JayceWork/Hardware_file/3D_step/ANT/ANT_5p5mmx2mm.step

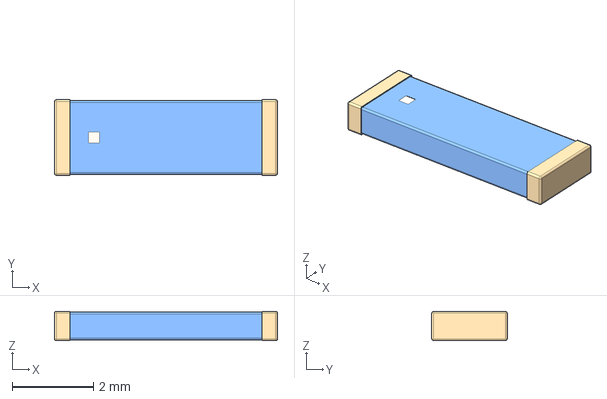
[picture p1: CAD file, 2022-02-21]
3D_step/ANT/ANT_5p5mmx2mm.step
5.50 x 1.86 x 0.727 mm
