JayceWork/Hardware_file/3D_step/Connector/1P25mm/1P25mm-2P-Horizontal.stp

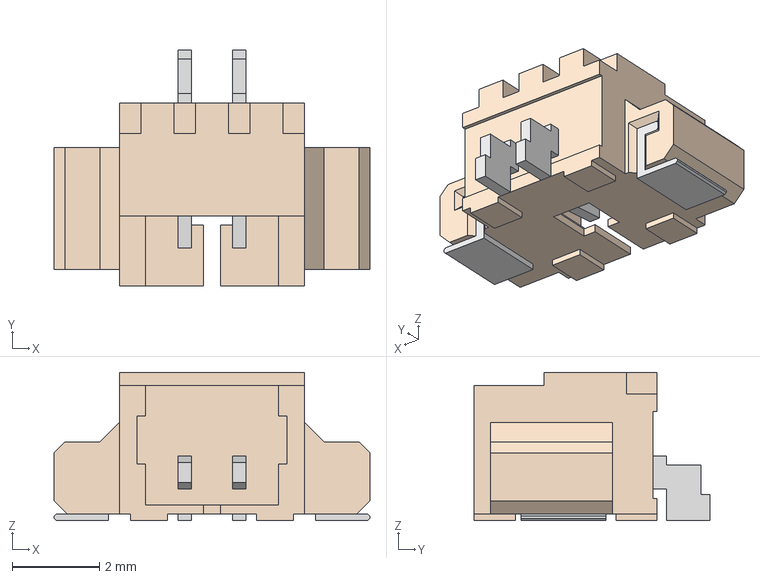
[picture p2: CAD file, 2022-02-11]
3D_step/Connector/1P25mm/1P25mm-2P-Horizontal.stp
7.25 x 5.41 x 3.41 mm
