JayceWork/Hardware_file/3D_step/Connector/FPC/FPC10-0.5mm-1.0H-rare.stp

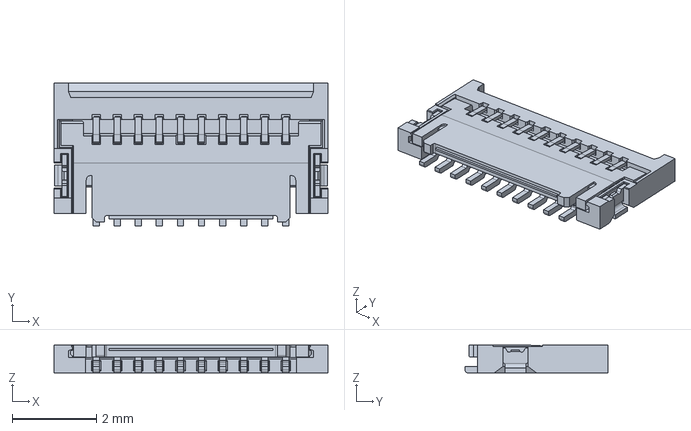
[picture p3: CAD file, 2022-03-13]
3D_step/Connector/FPC/FPC10-0.5mm-1.0H-rare.stp
6.50 x 3.40 x 0.66 mm
