JayceWork/Hardware_file/3D_step/Connector/NGFF/NGFF-B-4.2H.stp

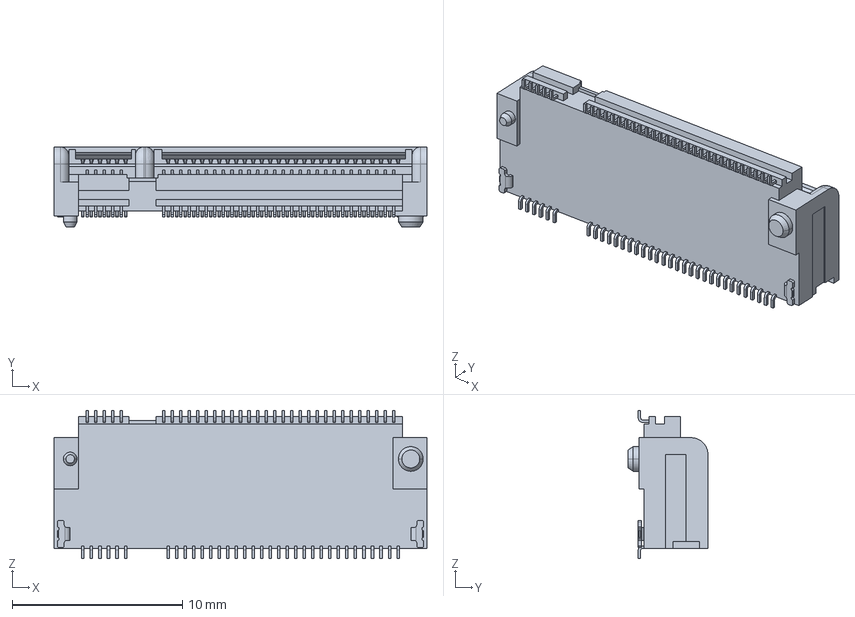
[picture p4: CAD file, 2022-02-10]
3D_step/Connector/NGFF/NGFF-B-4.2H.stp
21.9 x 4.70 x 8.70 mm
