JayceWork/Hardware_file/3D_step/Connector/PhoneJack/Phone_jack_PJ327A_5P_SMT.STEP

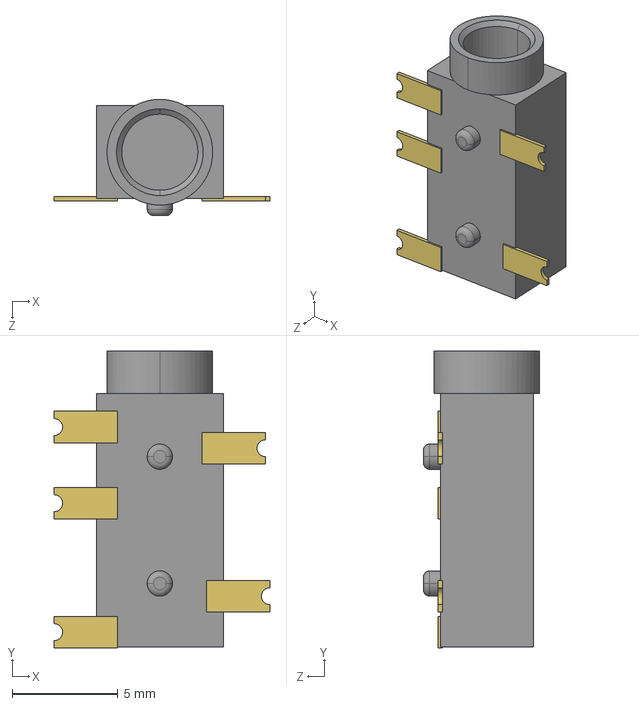
[picture p5: CAD file, 2022-03-13]
3D_step/Connector/PhoneJack/Phone_jack_PJ327A_5P_SMT.STEP
10.2 x 14.0 x 5.50 mm
