JayceWork/Hardware_file/3D_step/Connector/RJ11/RJ11-6P6C.stp

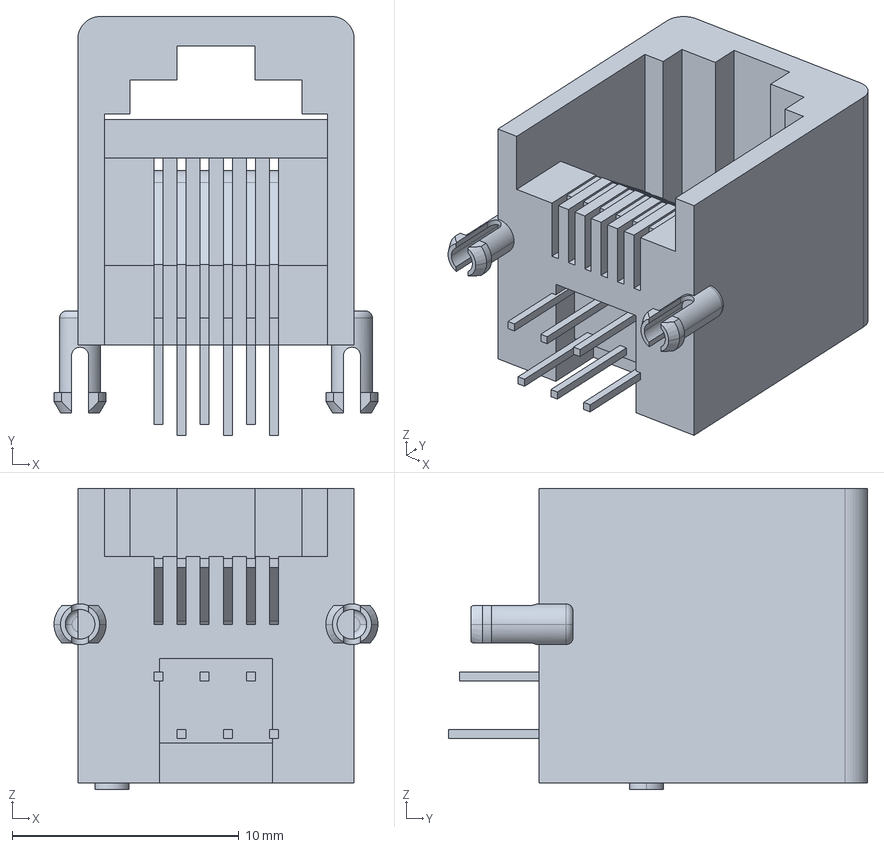
[picture p6: CAD file, 2022-02-10]
3D_step/Connector/RJ11/RJ11-6P6C.stp
14.3 x 18.5 x 13.3 mm
