JayceWork/Hardware_file/3D_step/Connector/TF/micro-SD.step

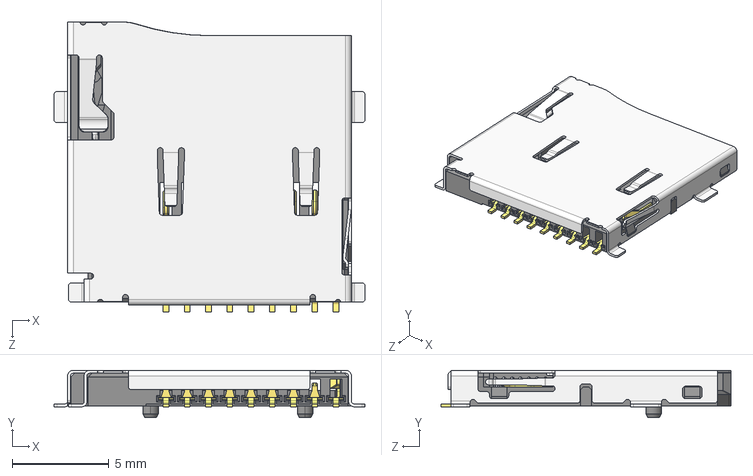
[picture p7: CAD file, 2021-10-09]
3D_step/Connector/TF/micro-SD.step
16.1 x 2.45 x 15.0 mm
