JayceWork/Hardware_file/3D_step/Connector/USB/usb_a-usb_a-top-c.stp

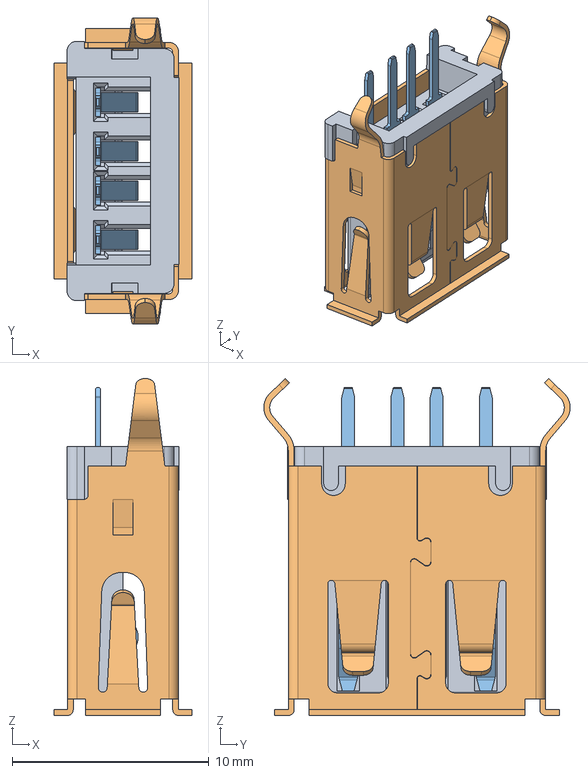
[picture p8: CAD file, 2022-02-26]
3D_step/Connector/USB/usb_a-usb_a-top-c.stp
7.00 x 15.6 x 17.2 mm
