JayceWork/Hardware_file/3D_step/Connector/User Library-IPEX.step

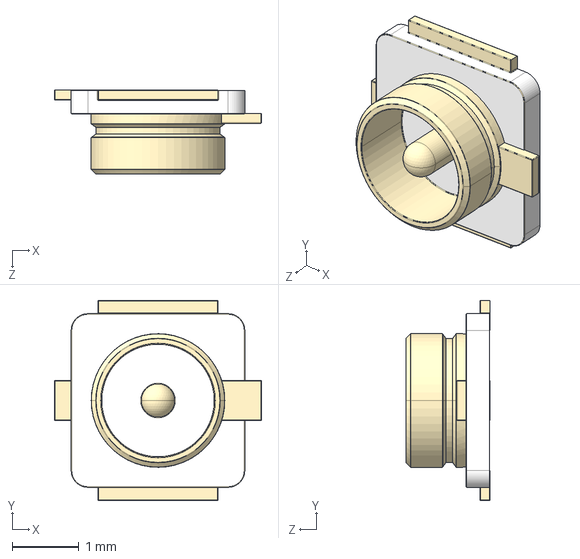
[picture p9: CAD file, 2022-02-10]
3D_step/Connector/User Library-IPEX.step
3.10 x 3.00 x 1.26 mm
