JayceWork/Hardware_file/3D_step/IC/User Library-3-lead sot23-3.step

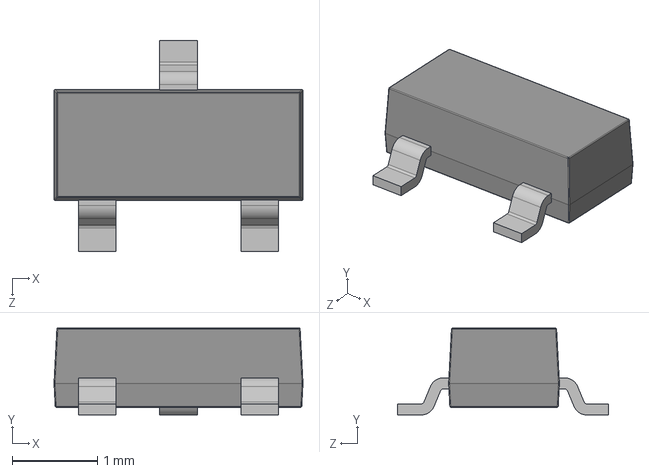
[picture p10: CAD file, 2022-03-13]
3D_step/IC/User Library-3-lead sot23-3.step
2.92 x 1.02 x 2.48 mm
