JayceWork/Hardware_file/3D_step/LRC/Inductor-SRT8045.step

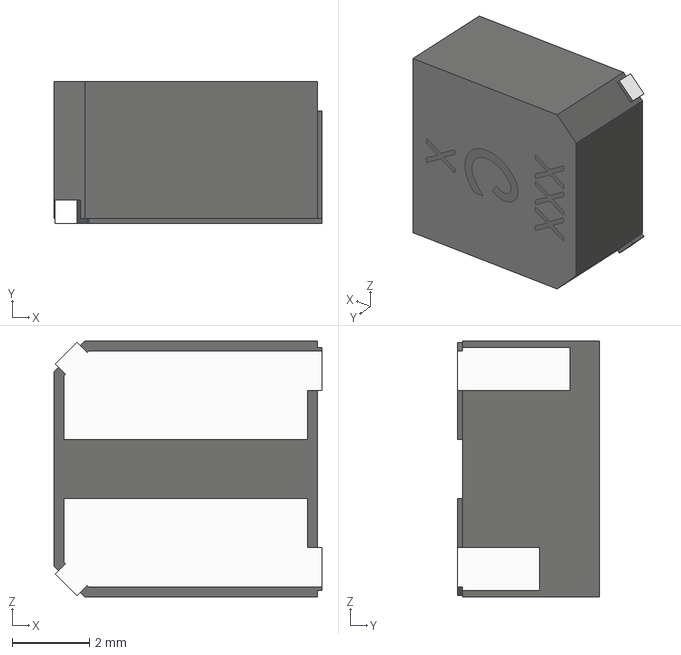
[picture p11: CAD file, 2021-10-22]
3D_step/LRC/Inductor-SRT8045.step
6.96 x 3.68 x 6.64 mm
