JayceWork/Hardware_file/3D_step/Things/Button_6 x 6 x 5.STEP

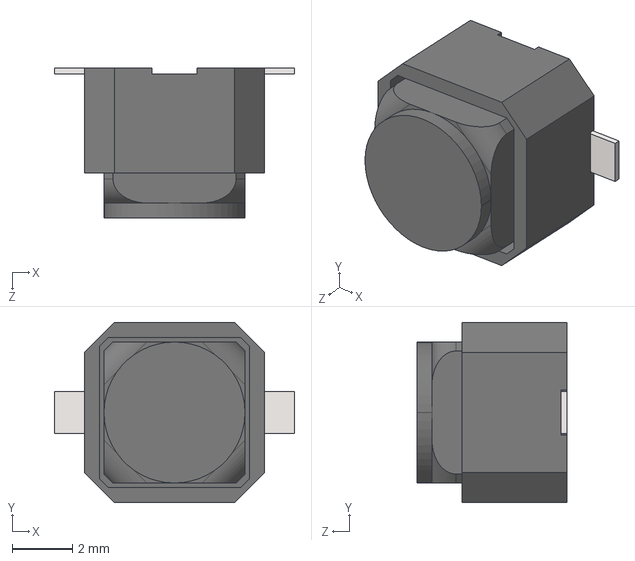
[picture p12: CAD file, 2022-03-13]
3D_step/Things/Button_6 x 6 x 5.STEP
8.00 x 6.00 x 5.00 mm
