JayceWork/Hardware_file/3D_step/Connector/1P25mm/1P25mm-4P-Horizontal.stp

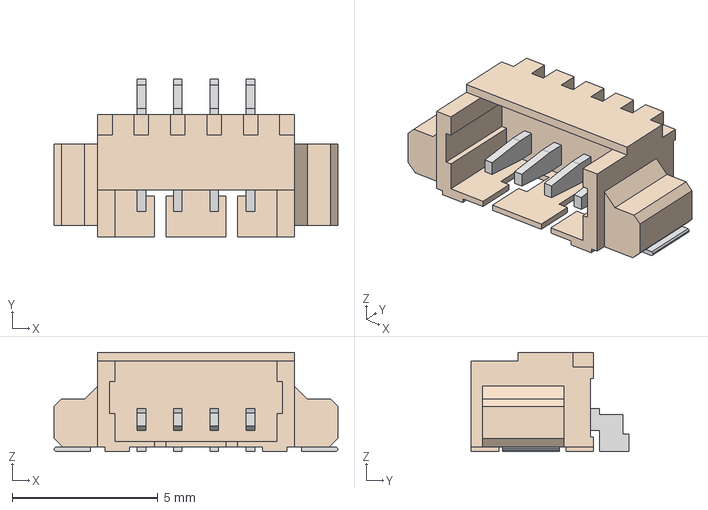
[picture p13: CAD file, 2022-02-11]
3D_step/Connector/1P25mm/1P25mm-4P-Horizontal.stp
9.75 x 5.41 x 3.41 mm
