JayceWork/Hardware_file/3D_step/Connector/FPC/FPC14-0.5mm-2.0H-rare.step

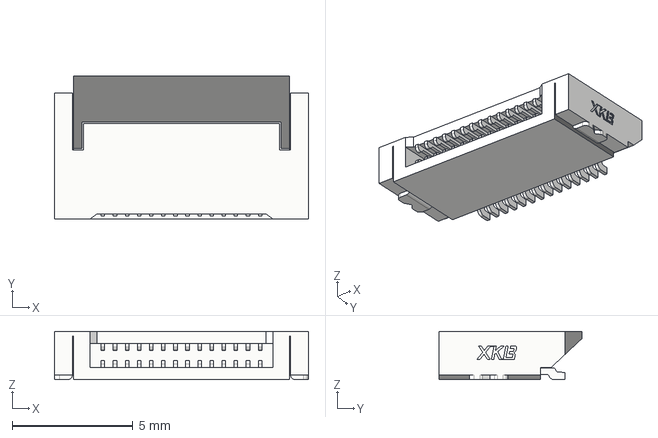
[picture p14: CAD file, 2022-03-13]
3D_step/Connector/FPC/FPC14-0.5mm-2.0H-rare.step
10.5 x 5.90 x 2.00 mm
