JayceWork/Hardware_file/3D_step/Connector/USB/USB-TYPE-C20.step

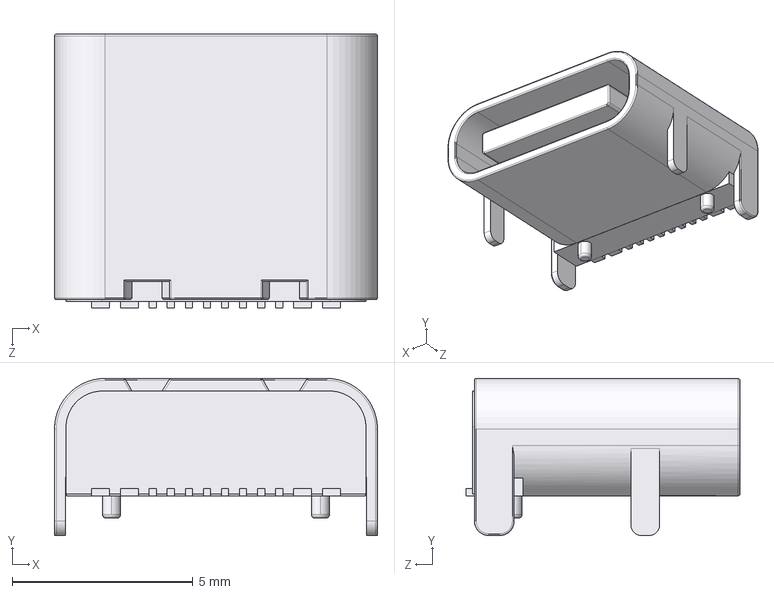
[picture p15: CAD file, 2021-10-09]
3D_step/Connector/USB/USB-TYPE-C20.step
8.94 x 4.35 x 7.58 mm
