JayceWork/Hardware_file/3D_step/IC/SOIC8.STEP

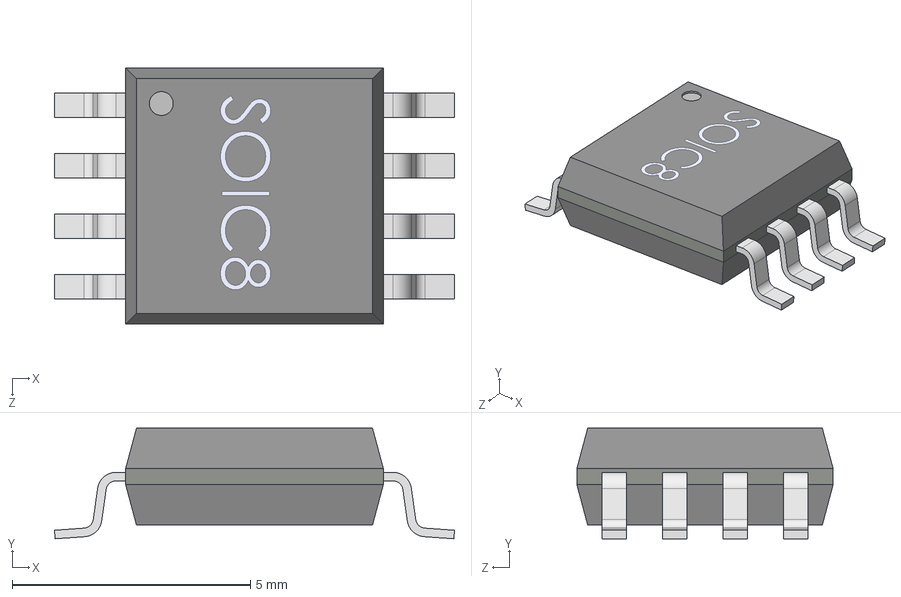
[picture p16: CAD file, 2022-02-17]
3D_step/IC/SOIC8.STEP
8.39 x 2.32 x 5.38 mm
