JayceWork/Hardware_file/3D_step/Things/User Library-Crystal FC-135.STEP

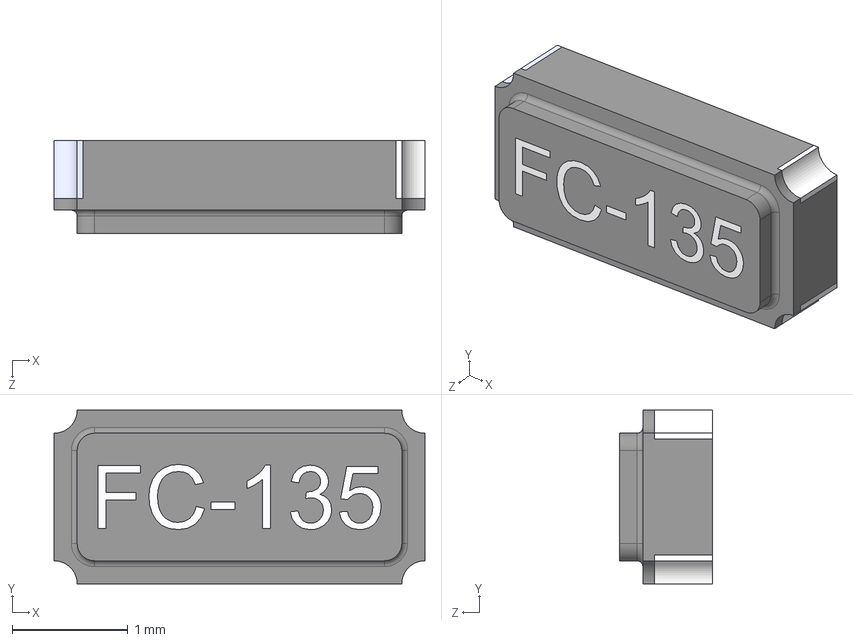
[picture p17: CAD file, 2022-02-12]
3D_step/Things/User Library-Crystal FC-135.STEP
3.20 x 1.50 x 0.8 mm
User Library-Crystal FC-135_Body
User Library-Crystal FC-135_Pin 2
User Library-Crystal FC-135_Pin 1
User Library-Crystal FC-135_Tekst Inlay
