JayceWork/Hardware_file/3D_step/Connector/FPC/FPC40-1.0H.step

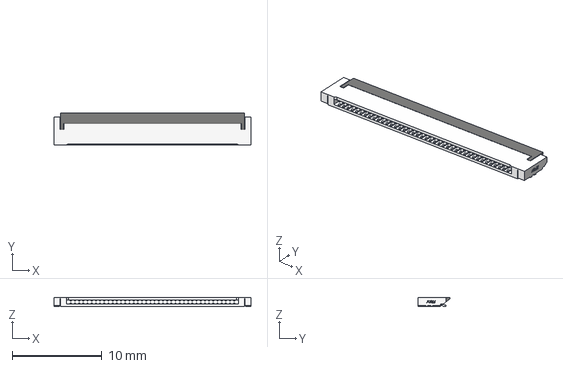
[picture p18: CAD file, 2022-02-26]
3D_step/Connector/FPC/FPC40-1.0H.step
22.0 x 3.54 x 1.00 mm
