JayceWork/Hardware_file/3D_step/IC/User Library-MSOP8.step

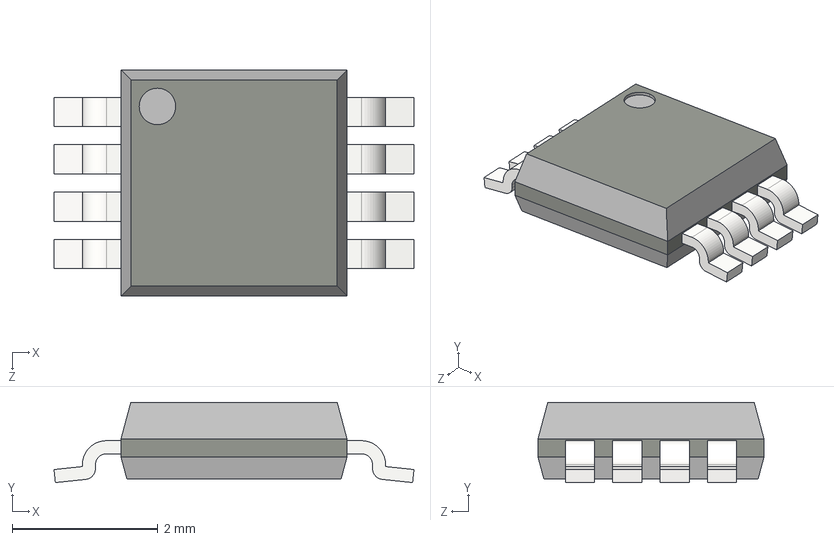
[picture p19: CAD file, 2022-02-10]
3D_step/IC/User Library-MSOP8.step
4.94 x 1.10 x 3.10 mm
