JayceWork/Hardware_file/3D_step/Things/model_49.step

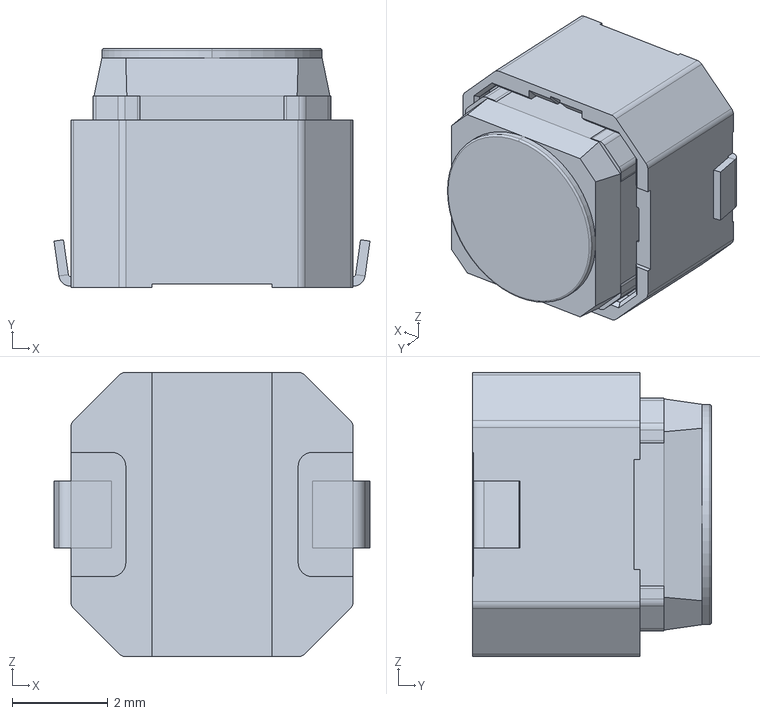
[picture p20: CAD file, 2022-02-11]
3D_step/Things/model_49.step
6.60 x 5.00 x 5.94 mm
