JayceWork/Hardware_file/3D_step/Connector/FPC/FPC30-0.5mm-1.0H-rare.step

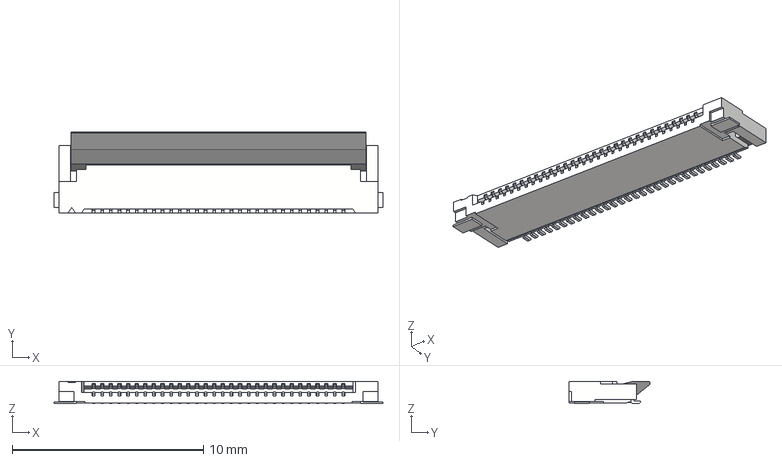
[picture p21: CAD file, 2022-02-26]
3D_step/Connector/FPC/FPC30-0.5mm-1.0H-rare.step
17.2 x 4.25 x 1.15 mm
XF2M_3015_1A
