JayceWork/Hardware_file/3D_step/IC/ESD_HDMI_2510.step

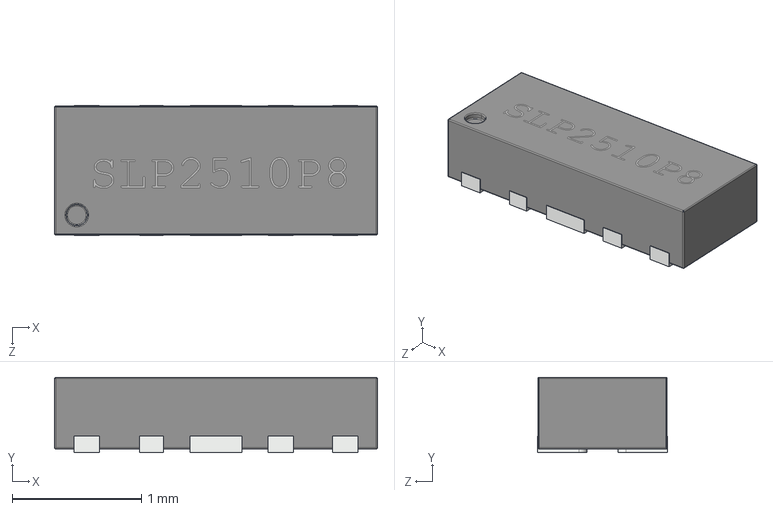
[picture p22: CAD file, 2021-10-29]
3D_step/IC/ESD_HDMI_2510.step
2.50 x 0.584 x 1.01 mm
