JayceWork/Hardware_file/3D_step/Things/User Library-Battery Holder for CR1220 SMD.step

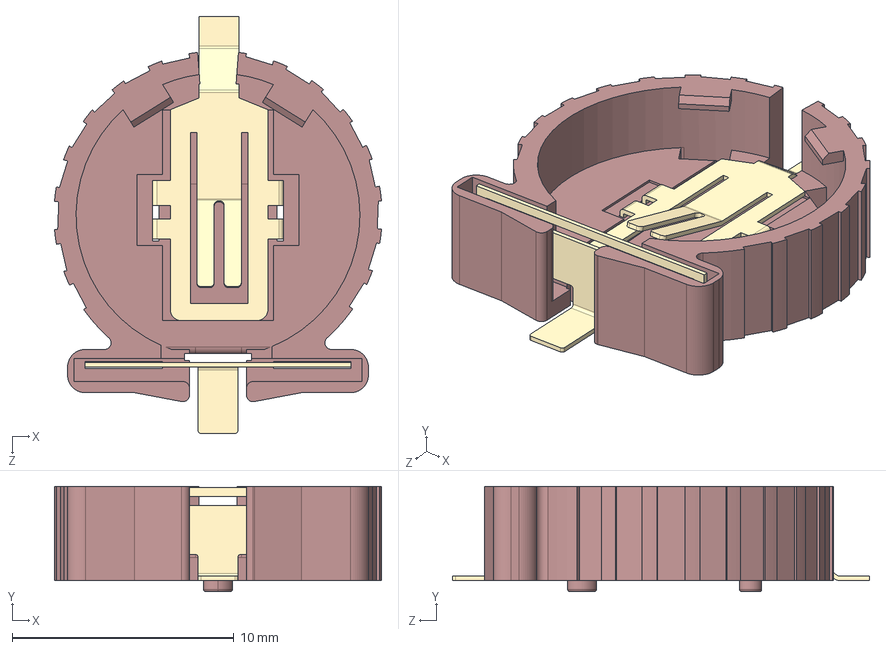
[picture p23: CAD file, 2022-02-11]
3D_step/Things/User Library-Battery Holder for CR1220 SMD.step
14.7 x 4.75 x 18.8 mm
