JayceWork/Hardware_file/3D_step/Connector/FPC/FPC30-0.5mm-2.0H-rare.step

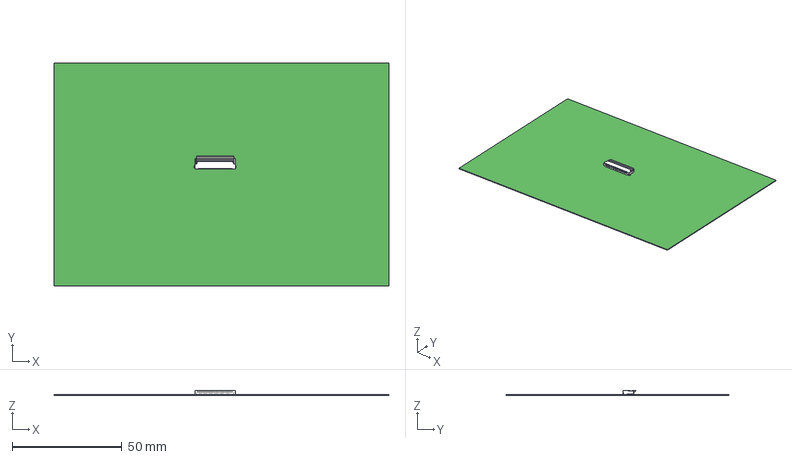
[picture p24: CAD file, 2022-02-26]
3D_step/Connector/FPC/FPC30-0.5mm-2.0H-rare.step
152.4 x 101.6 x 2.41 mm
XF2M_3015_1A
