JayceWork/Hardware_file/3D_step/IC/User Library-DFN8-5X6.STEP

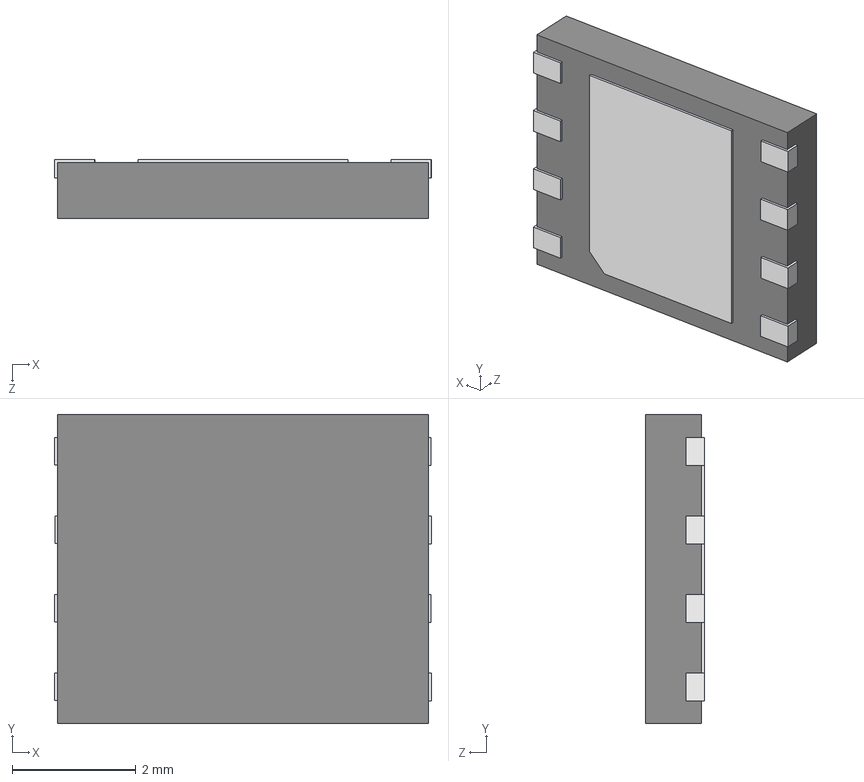
[picture p25: CAD file, 2021-10-22]
3D_step/IC/User Library-DFN8-5X6.STEP
6.10 x 5.00 x 0.95 mm
