JayceWork/Hardware_file/3D_step/Connector/FPC/FPC12-0.5mm-2.0H-rare.step

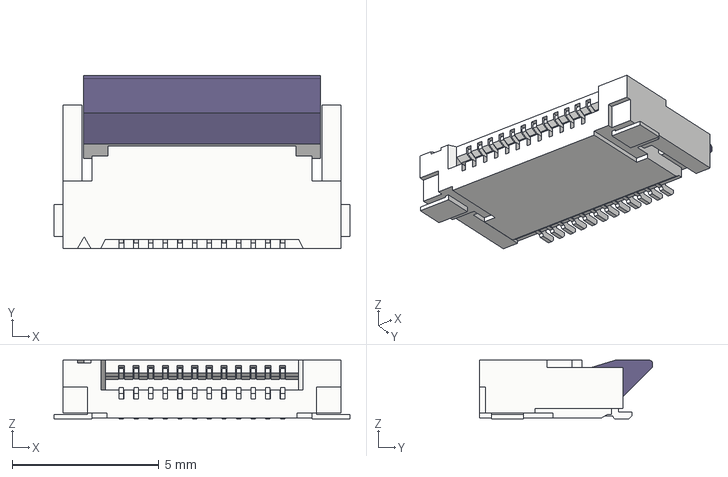
[picture p26: CAD file, 2022-02-21]
3D_step/Connector/FPC/FPC12-0.5mm-2.0H-rare.step
10.1 x 5.90 x 2.00 mm
