JayceWork/Hardware_file/3D_step/IC/User Library-sop-8.step

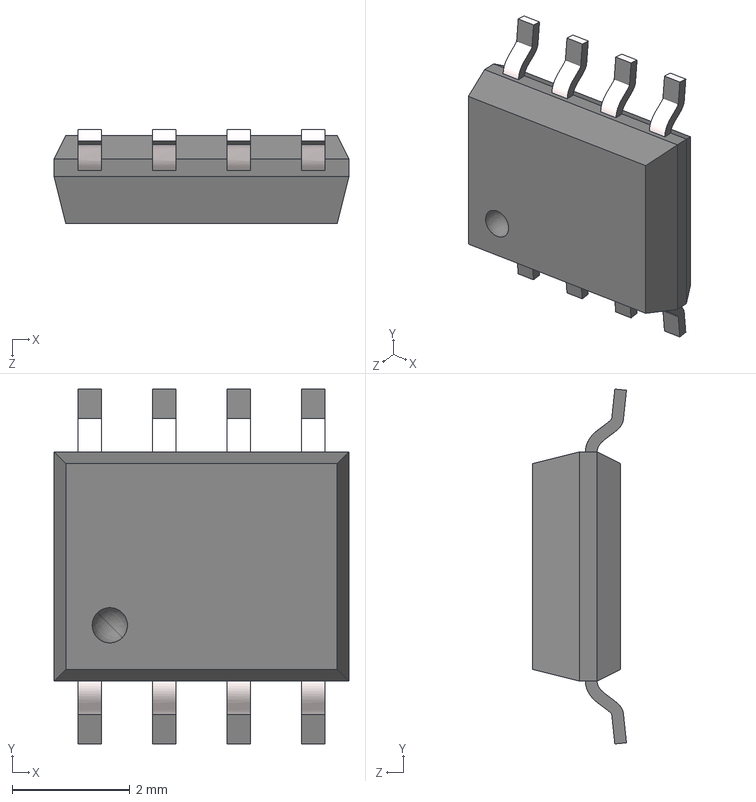
[picture p27: CAD file, 2021-10-13]
3D_step/IC/User Library-sop-8.step
5.02 x 6.04 x 1.60 mm
