JayceWork/Hardware_file/3D_step/Things/SMD16-100M.step

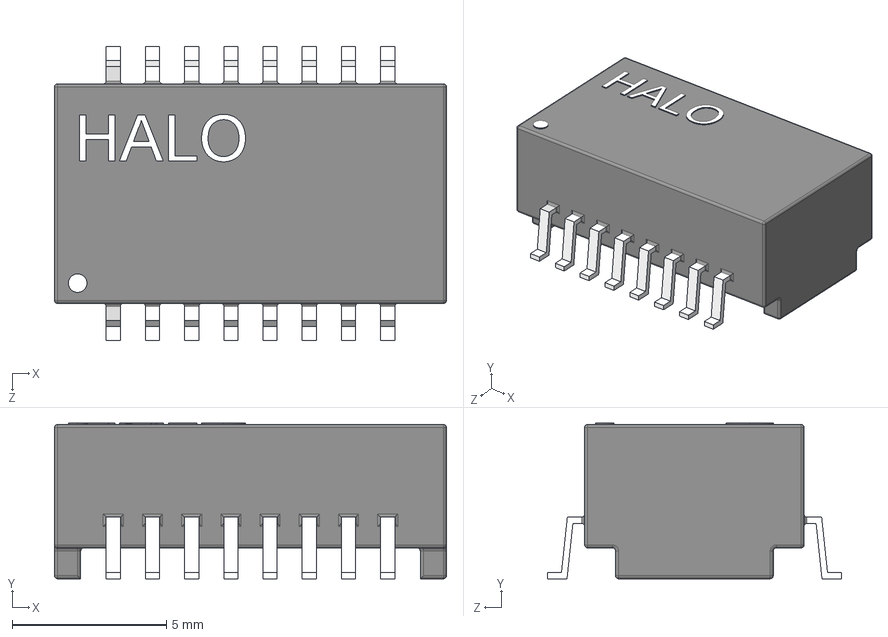
[picture p28: CAD file, 2022-01-26]
3D_step/Things/SMD16-100M.step
12.7 x 5.04 x 9.52 mm
