JayceWork/Hardware_file/3D_step/Connector/FPC/FPC6-0.5mm-1.0H-rare.step

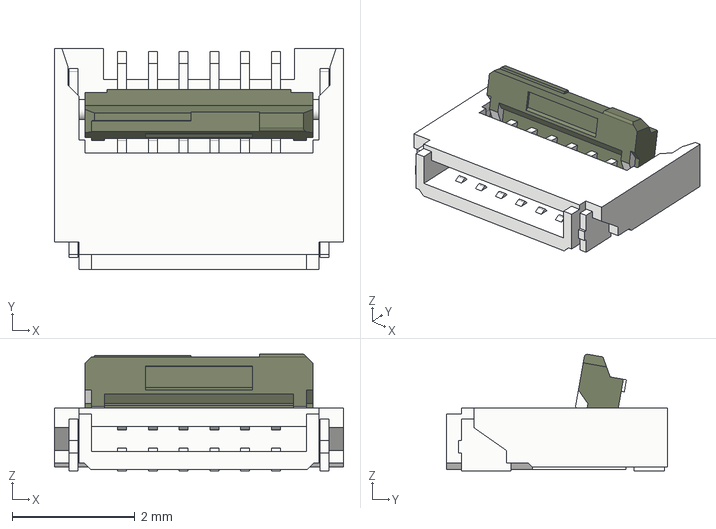
[picture p29: CAD file, 2022-02-21]
3D_step/Connector/FPC/FPC6-0.5mm-1.0H-rare.step
4.70 x 3.60 x 1.89 mm
