JayceWork/Hardware_file/3D_step/IC/User Library-QFN88.step

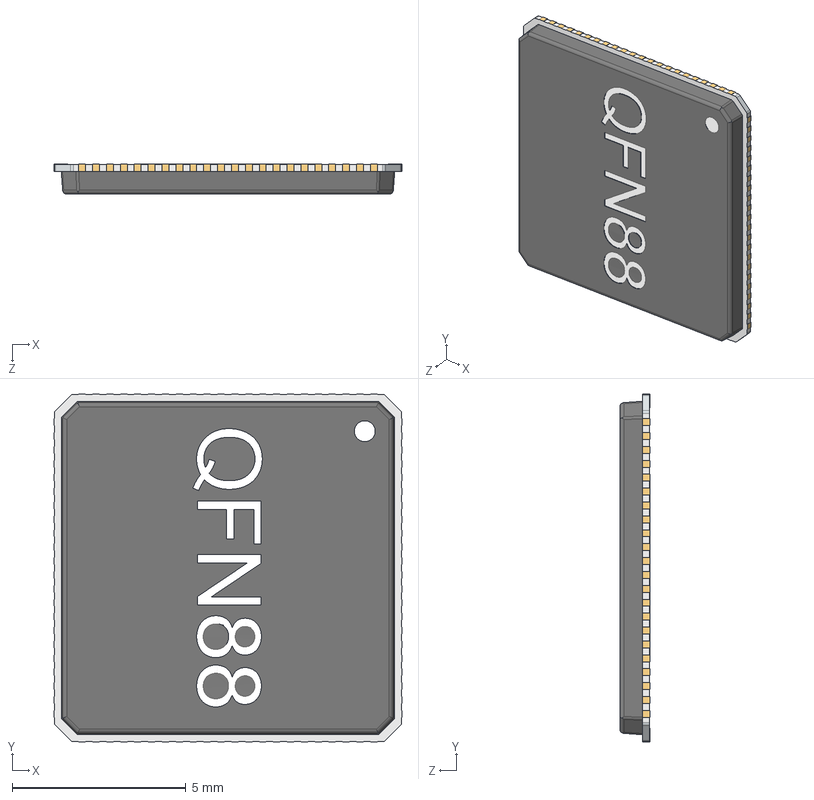
[picture p30: CAD file, 2021-10-09]
3D_step/IC/User Library-QFN88.step
10.0 x 10.0 x 0.87 mm
