JayceWork/Hardware_file/3D_step/Things/Button_3x4.step

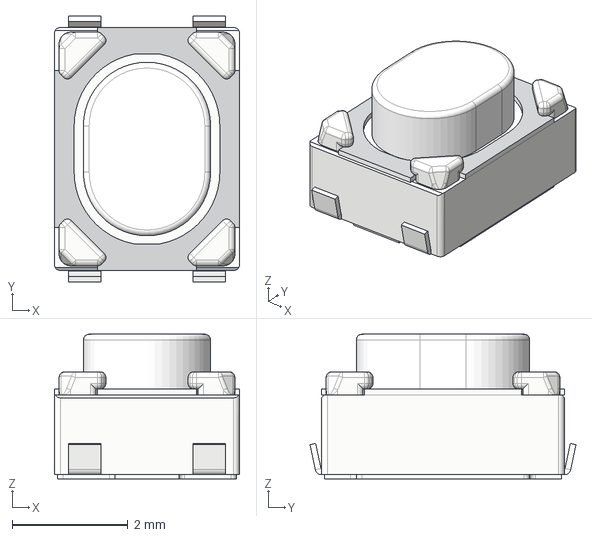
[picture p31: CAD file, 2021-12-03]
3D_step/Things/Button_3x4.step
3.20 x 4.60 x 2.50 mm
