JayceWork/Hardware_file/3D_step/Connector/FPC/FPC24-0.5mm-rare.STEP

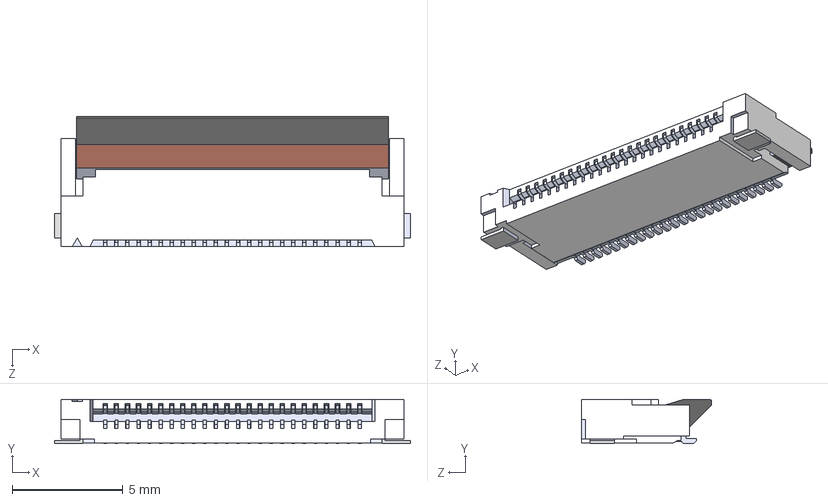
[picture p32: CAD file, 2022-02-10]
3D_step/Connector/FPC/FPC24-0.5mm-rare.STEP
16.1 x 2.00 x 5.90 mm
