JayceWork/Hardware_file/3D_step/IC/User Library-QFN-20-2.step

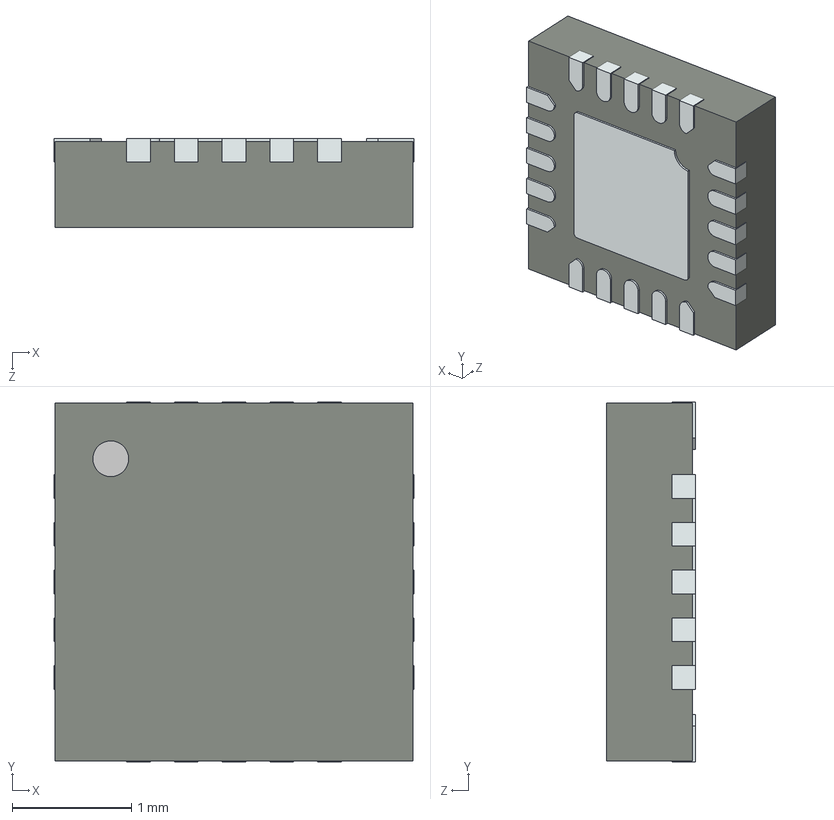
[picture p33: CAD file, 2021-10-09]
3D_step/IC/User Library-QFN-20-2.step
3.02 x 3.02 x 0.75 mm
