JayceWork/Hardware_file/3D_step/Things/Crystal_2016.STEP

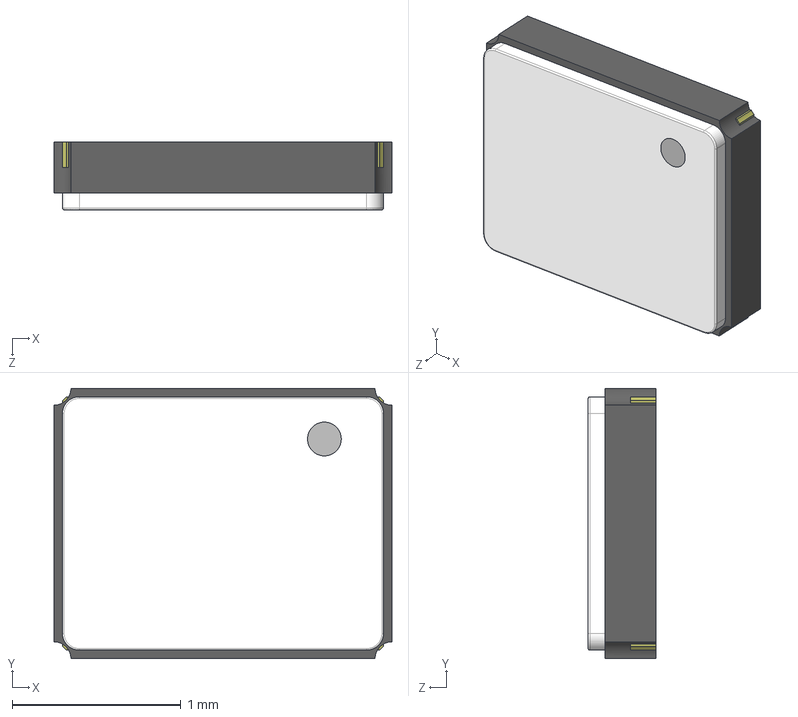
[picture p34: CAD file, 2021-10-09]
3D_step/Things/Crystal_2016.STEP
2.00 x 1.60 x 0.4 mm
ACIS Solid_1923
ACIS Solid_1935
