JayceWork/Hardware_file/3D_step/Connector/FPC/FPC-0.3MM-21P.step

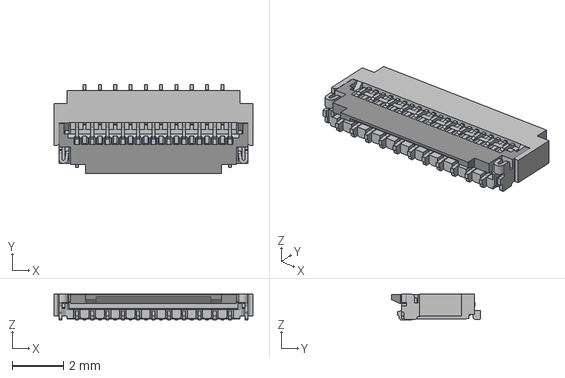
[picture p35: CAD file, 2021-12-03]
3D_step/Connector/FPC/FPC-0.3MM-21P.step
7.80 x 3.50 x 1 mm
