JayceWork/Hardware_file/3D_step/IC/User Library-8 WSON.step

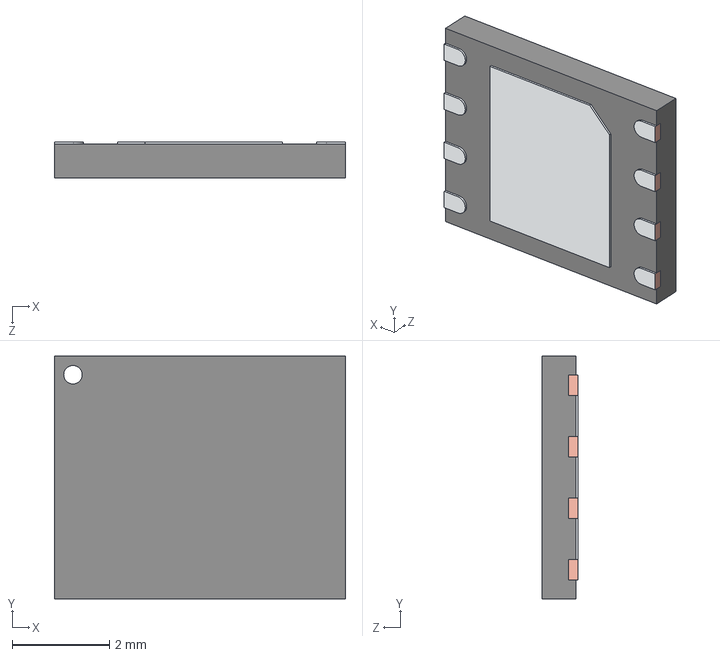
[picture p36: CAD file, 2021-10-09]
3D_step/IC/User Library-8 WSON.step
6.00 x 5.00 x 0.75 mm
