JayceWork/Hardware_file/3D_step/Things/LED_0603.step

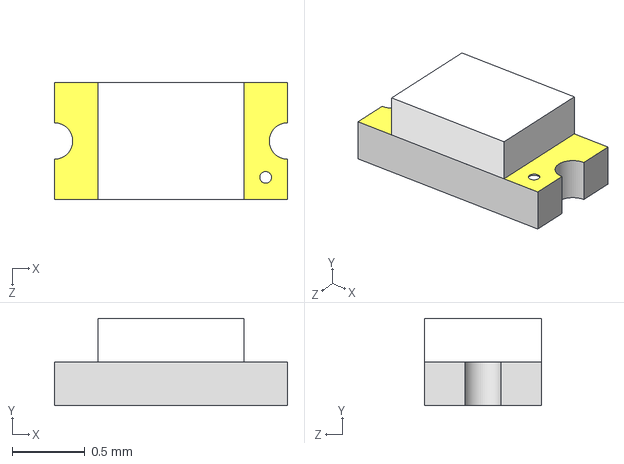
[picture p37: CAD file, 2021-10-09]
3D_step/Things/LED_0603.step
1.60 x 0.6 x 0.8 mm
