JayceWork/Hardware_file/3D_step/Connector/FPC/FPC8-01.step

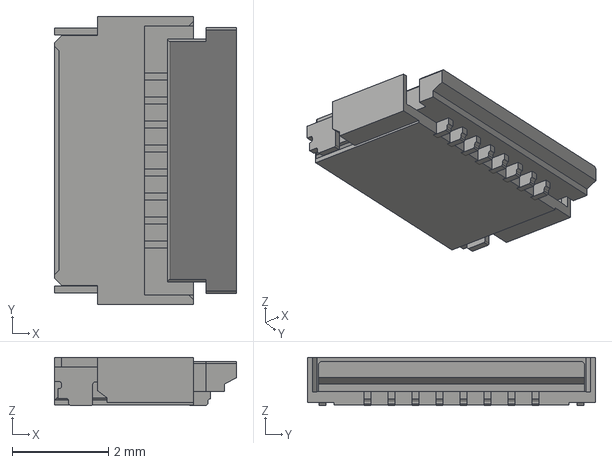
[picture p38: CAD file, 2021-10-09]
3D_step/Connector/FPC/FPC8-01.step
3.80 x 6.00 x 1.00 mm
