JayceWork/Hardware_file/3D_step/Things/L_3015.step

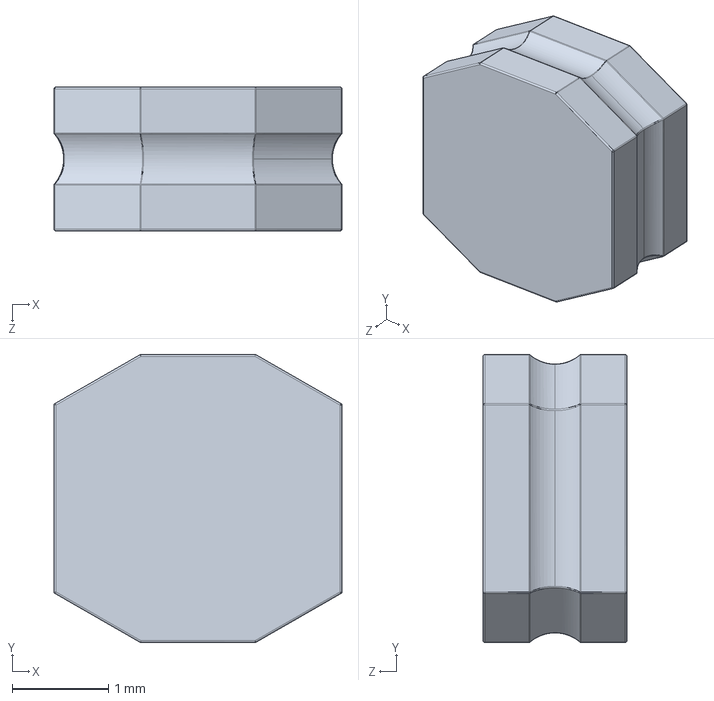
[picture p39: CAD file, 2021-10-09]
3D_step/Things/L_3015.step
3.00 x 3.00 x 1.50 mm
