JayceWork/Hardware_file/3D_step/Connector/FPC/FPC40.step

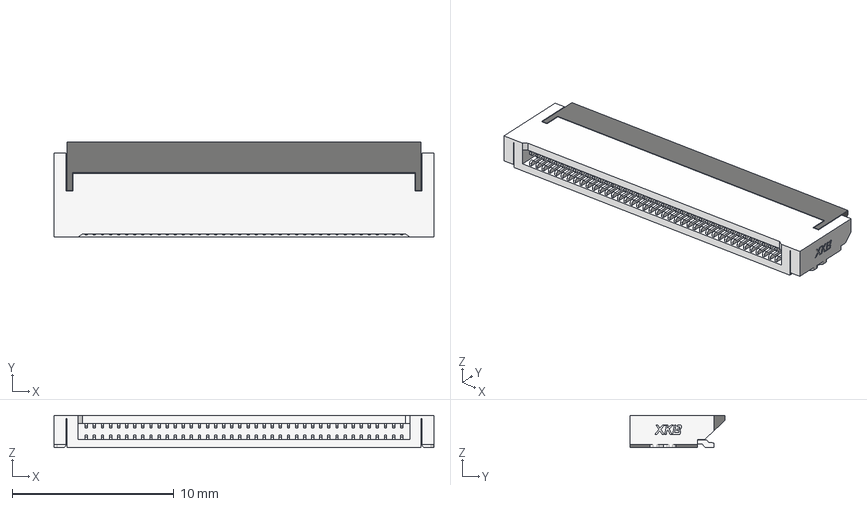
[picture p40: CAD file, 2021-10-09]
3D_step/Connector/FPC/FPC40.step
23.5 x 5.90 x 2.00 mm
