JayceWork/Hardware_file/3D_step/Things/L_4020.step

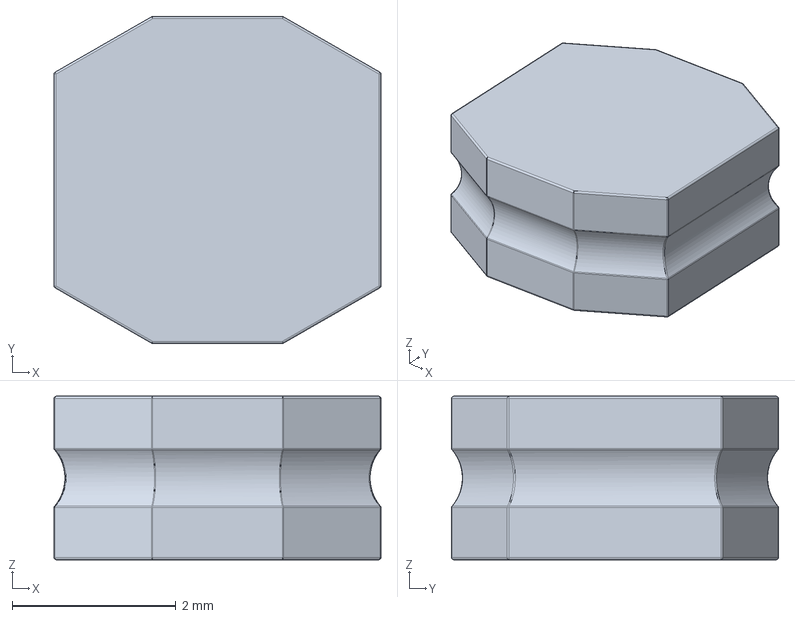
[picture p41: CAD file, 2021-10-09]
3D_step/Things/L_4020.step
3.99 x 3.99 x 1.99 mm
