JayceWork/Hardware_file/(list of files, cad)

Other CAD files:
3D_step/Connector/FPC/FPC8-0.5mm-rare.stp
3D_step/Things/M2-nut_smt.stp
