JayceWork/Hardware_file/(list of files, drawings)

Other design files:
KICAD_config/pcb_calculator.json
