JayceWork/Hardware_file/(commit log)

2021-10-13 “update:2021/10/13”
    [Inductor-SRT8045.step, User Library-sop-8.step]
2021-10-22 General update:2021-10-22
    [Molex_5055513420.stp]
2021-10-29 Optimized the paste layer
    [ESD_HDMI_2510.step, Molex_505550-3420.stp]
